XintingXu/BJ14141/README.md

# BJ14141
北京理工大学校级大学生创新计划“基于移动终端的温湿度可视调控系统”&
北京市级大学生创新创业计划项目“基于移动终端的温湿度调控系统”部分代码。

代码运行于ARDUINO平台，与具体的硬件信息有一定的关联。
