XintingXu/BJ14141/get_sensor_value/yl_messenger.cpp

#include "yl_messenger.h"
#include "yl_sensor.h"
#include "yl_tcp_client.h"

//#define YL_SERIAL_DEBUG

#define YEELINK_VERSION ("v1.0")

	yl_messenger::yl_messenger()
		: version_(YEELINK_VERSION)
		, client_(NULL)
	{}

	yl_messenger::yl_messenger(yl_tcp_client *client)
		: version_(YEELINK_VERSION)
		, client_(client)
	{}

	yl_messenger::yl_messenger(const String &api_key, const String &host)
		: api_key_(api_key)
		, host_(host)
		, version_(YEELINK_VERSION)
		, client_(NULL)
	{}

	yl_messenger::yl_messenger(yl_tcp_client *client, const String &api_key, const String &host)
		: api_key_(api_key)
		, host_(host)
		, version_(YEELINK_VERSION)
		, client_(client)
	{}

	void yl_messenger::set_api_key(const String &api_key)
	{
		api_key_ = api_key;
	}

	const String& yl_messenger::get_api_key() const
	{
		return api_key_;
	}

	String& yl_messenger::get_api_key()
	{
		return api_key_;
	}

	void yl_messenger::set_host(const String &host)
	{
		host_ = host;
	}

	const String& yl_messenger::get_host() const
	{
		return host_;
	}

	String& yl_messenger::get_host()
	{
		return host_;
	}

	void yl_messenger::set_version(const String &version)
	{
		version_ = version;
	}

	const String& yl_messenger::get_version() const
	{
		return version_;
	}

	String& yl_messenger::get_version()
	{
		return version_;
	}

	void yl_messenger::set_tcp_client(yl_tcp_client *client)
	{
		client_ = client;
	}

	const yl_tcp_client* yl_messenger::get_tcp_client() const
	{
		return client_;
	}

	yl_tcp_client* yl_messenger::get_tcp_client()
	{
		return client_;
	}

	bool yl_messenger::connect_yl()
	{
		return client_->connect(&host_[0], 80);
	}

	bool yl_messenger::request_post(const yl_sensor &sensor, const yl_data_point &dp, bool keep_alive)
	{
		String data = dp.to_string();
		if (data.length() == 0)
		{
			return false;
		}
		String connection = keep_alive ? "\r\n" : "Connection:close\r\n\r\n";
		String temp("POST /");
		temp += version_;
		temp += "/device/";
		if (!client_->send(temp)
			|| !client_->send(sensor.get_device()->get_id())
			|| !client_->send("/sensor/") 
			|| !client_->send(sensor.get_id())
			|| !client_->send("/datapoints HTTP/1.1\r\nHost:")
			|| !client_->send(host_)
			|| !client_->send("\r\nAccept:*/*\r\nU-ApiKey:")
			|| !client_->send(api_key_)
			|| !client_->send("\r\nContent-Length:")
			|| !client_->send_ln(data.length())
			|| !client_->send("Content-Type:application/x-www-form-urlencoded\r\n")
			|| !client_->send(connection)
			|| !client_->send(data))
		{
#ifdef YL_SERIAL_DEBUG
			Serial.println("send error : 108");
#endif
			return false;
		}
		return true;
	}

	bool yl_messenger::get_request_result()
	{
		String temp;
		if (!recv_ln(temp))
		{
#ifdef YL_SERIAL_DEBUG
			Serial.println("recv error : 122");
#endif
			return false;
		}
		long start_index = temp.indexOf(' ');
		temp = temp.substring(start_index + 1);
		temp.trim();
		long end_index = temp.indexOf(' ');
		temp = temp.substring(0, end_index);
		temp.trim();
		return temp[0] == '2';
	}

	bool yl_messenger::request_get(const yl_sensor &sensor, const String &key, bool keep_alive)
	{
		String temp("GET /");
		temp += version_;
		temp += "/device/";
		if (!client_->send(temp)
			|| !client_->send(sensor.get_device()->get_id())
			|| !client_->send("/sensor/")
			|| !client_->send(sensor.get_id())
			|| !client_->send("/datapoints/"))
		{
#ifdef YL_SERIAL_DEBUG
			Serial.println("send error : 144");
#endif
			return false;
		}
		String connection = keep_alive ? "\r\n\r\n" : "\r\nConnection:close\r\n\r\n";
		if ((key.length() && !client_->send(key))
			|| !client_->send(" HTTP/1.1\r\nHost:")
			|| !client_->send(host_)
			|| !client_->send("\r\nU-ApiKey:")
			|| !client_->send(api_key_)
			|| !client_->send(connection))
		{
#ifdef YL_SERIAL_DEBUG
			Serial.println("send error : 156");
#endif
			return false;
		}
		return true;
	}

	bool yl_messenger::recv_get_data(String &data)
	{
		if (!get_request_result())
		{
#ifdef YL_SERIAL_DEBUG
			Serial.println("send error : 168");
#endif
			return false;
		}
		if (!recv_ln_start_with("{", data))
		{
#ifdef YL_SERIAL_DEBUG
			Serial.println("recv error : 193");
#endif
			return false;
		}
		return true;
	}

	bool yl_messenger::recv_ln(String &data)
	{
		long result = 0;
		for (uint8_t step=0;step < 2;)
		{
			if ((result = client_->recv()) <= 0) 
			{
#ifdef YL_SERIAL_DEBUG
				Serial.println("read error : 190");
#endif
				return false;
			}
			if (step == 0 && result == '\r')
			{
				step = 1;
				continue;
			}
			if (step == 1)
			{
				if (result == '\n')
				{
					step = 2;
				} 
				else
				{
					step = 0;
					data += '\r';
				}
				continue;
			}
			data += char(result);
		}
		return true;
	}

	bool yl_messenger::recv_ln_start_with(const String start, String &data)
	{
		String start_temp(start);
		start_temp.toLowerCase();
		for (;;)
		{
			String temp;
			if (!recv_ln(temp))
			{
#ifdef YL_SERIAL_DEBUG
				Serial.println("read error : 245");
#endif
				return false;
			}
			temp.toLowerCase();
			if (temp == start_temp)
			{
				return recv_ln(data);
			}
			if (temp.substring(0, start_temp.length()) == start_temp)
			{
				data = temp.substring(start_temp.length());
				return true;
			}
		}
		return false;
	}

	void yl_messenger::flush_stop()
	{
		client_->flush();
		client_->stop();
	}
